johnp0704/Programmable-Guitar-Pedal/Images/Delay_Pedal_Sort_of.png

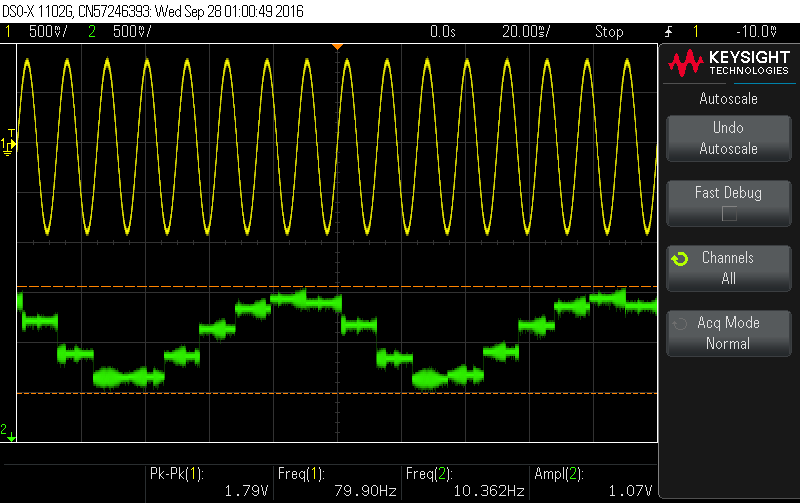
Images/Delay_Pedal_Sort_of.png
