johnp0704/Programmable-Guitar-Pedal/Images/Distortion_Pedal.png

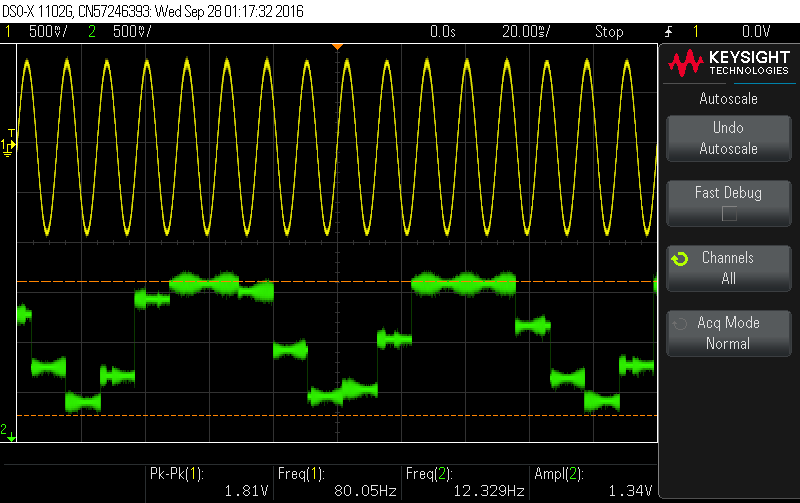
Images/Distortion_Pedal.png
