johnp0704/Programmable-Guitar-Pedal/Images/Final_Circuit_Output.png

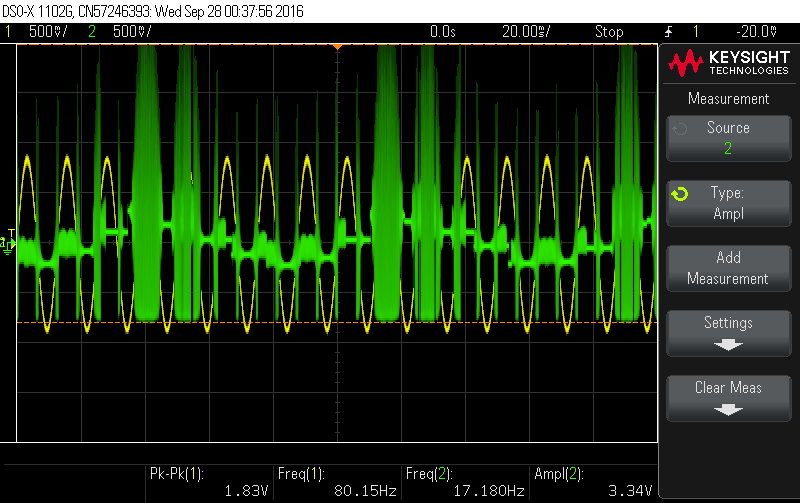
Images/Final_Circuit_Output.png
