johnp0704/Programmable-Guitar-Pedal/Images/Output_To_Arduino_Bad.png

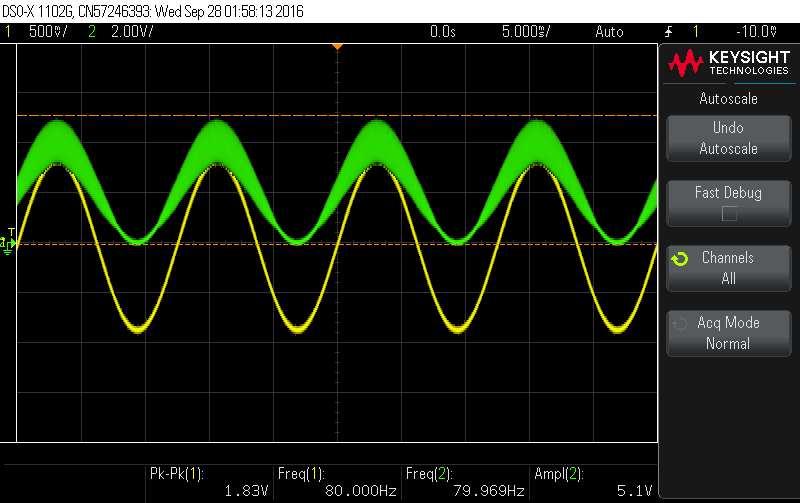
Images/Output_To_Arduino_Bad.png
