johnp0704/Programmable-Guitar-Pedal/Images/OutputAtDAC.png

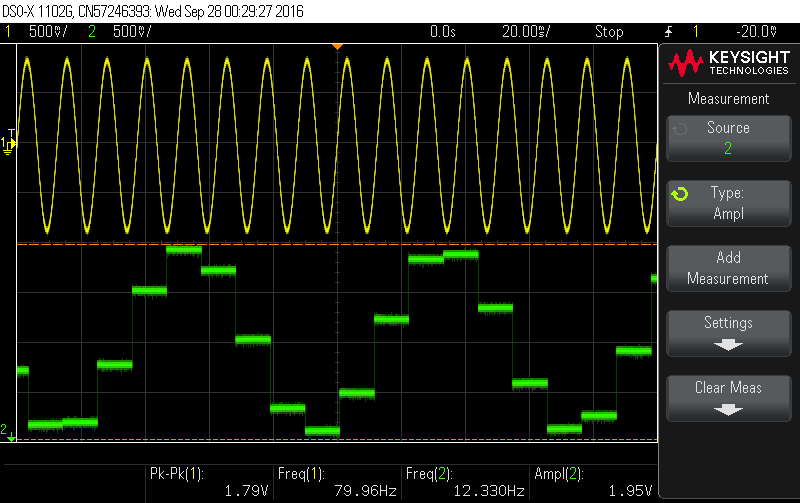
Images/OutputAtDAC.png
