johnp0704/Programmable-Guitar-Pedal/Input_Output_Processing_Circuits_LTspice.asc

C1: cap; 1µ
C2: cap; 1µ
D1: zener; UMZ5_1N
D2: zener; UMZ5_1N
R1: res; 100k
R2: res; 250k
R3: res; 1k
R4: res; 1k
R5: res; 3k
R6: res; 1k
R7: res; 250k
R8: res; 100k
R9: res; 1k
R11: res; 750
U1: AD744
U2: AD744
U3: AD744
U4: AD744
U6: AD744
V1: voltage; SINE(0 150m 80)
V2: voltage; 9
V3: voltage; 9
V4: voltage; 9
V5: voltage; 9
V6: voltage; 9
V7: voltage; 9
V8: voltage; -9
V9: voltage; SINE(2.5 2.5 80)
V10: voltage; 9
V12: voltage; 9
V14: voltage; 9
V15: voltage; 9
Named nets: 0
.tran .2
Input Stage
Output Stage
