johnp0704/Programmable-Guitar-Pedal/(commit log)

2024-12-11 Pedal Codes
    A collection of codes for different pedal effects. All codes are unconfirmed to work with the documented circuit as the circuit was unable to produce a sufficient output for a guitar amp to read.
2024-12-12 Update Loop_Pedal_V1.ino
    Typo Fix
    [Loop_Pedal_V1.ino]
